hflocki/camper-heater/docs/lochraster.png

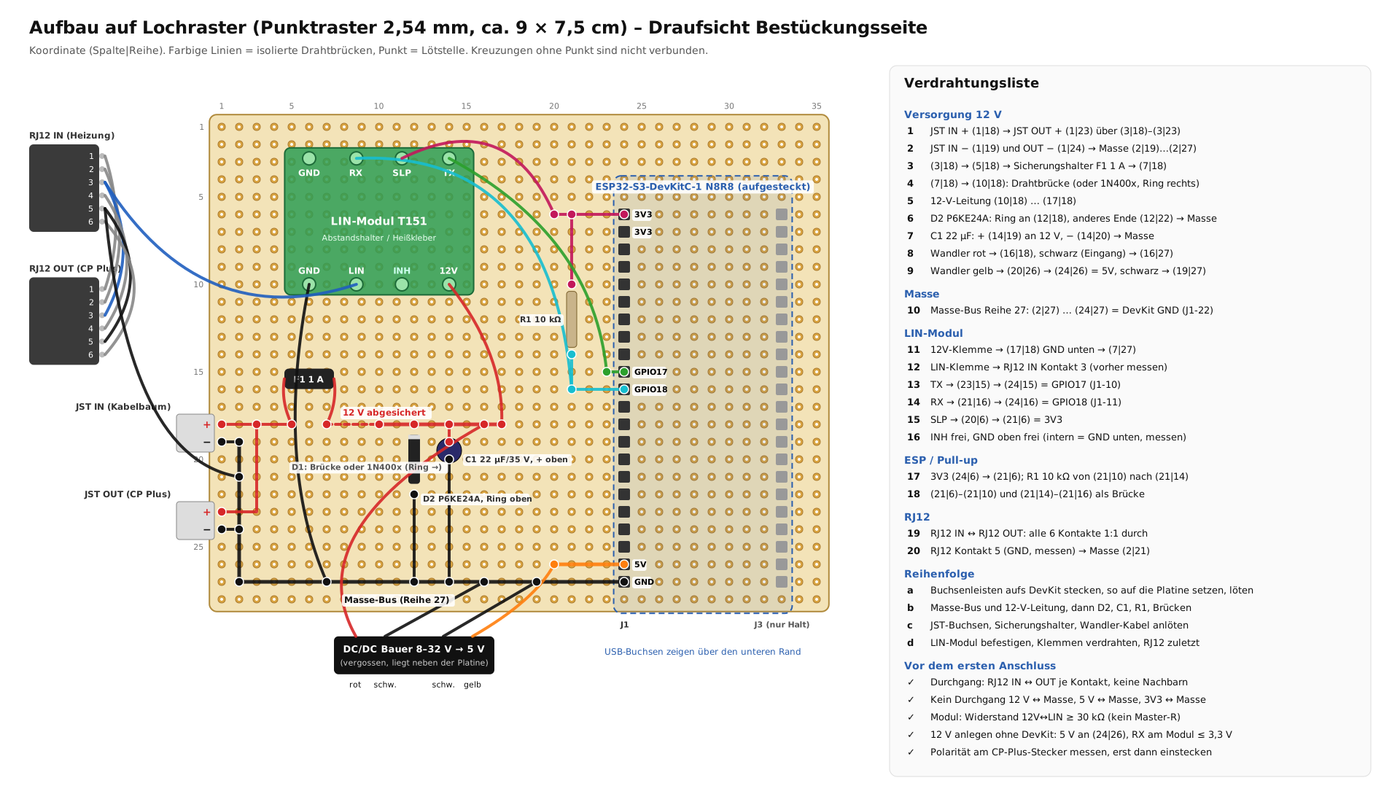
docs/lochraster.png
