hflocki/camper-heater/docs/lochraster_c3.png

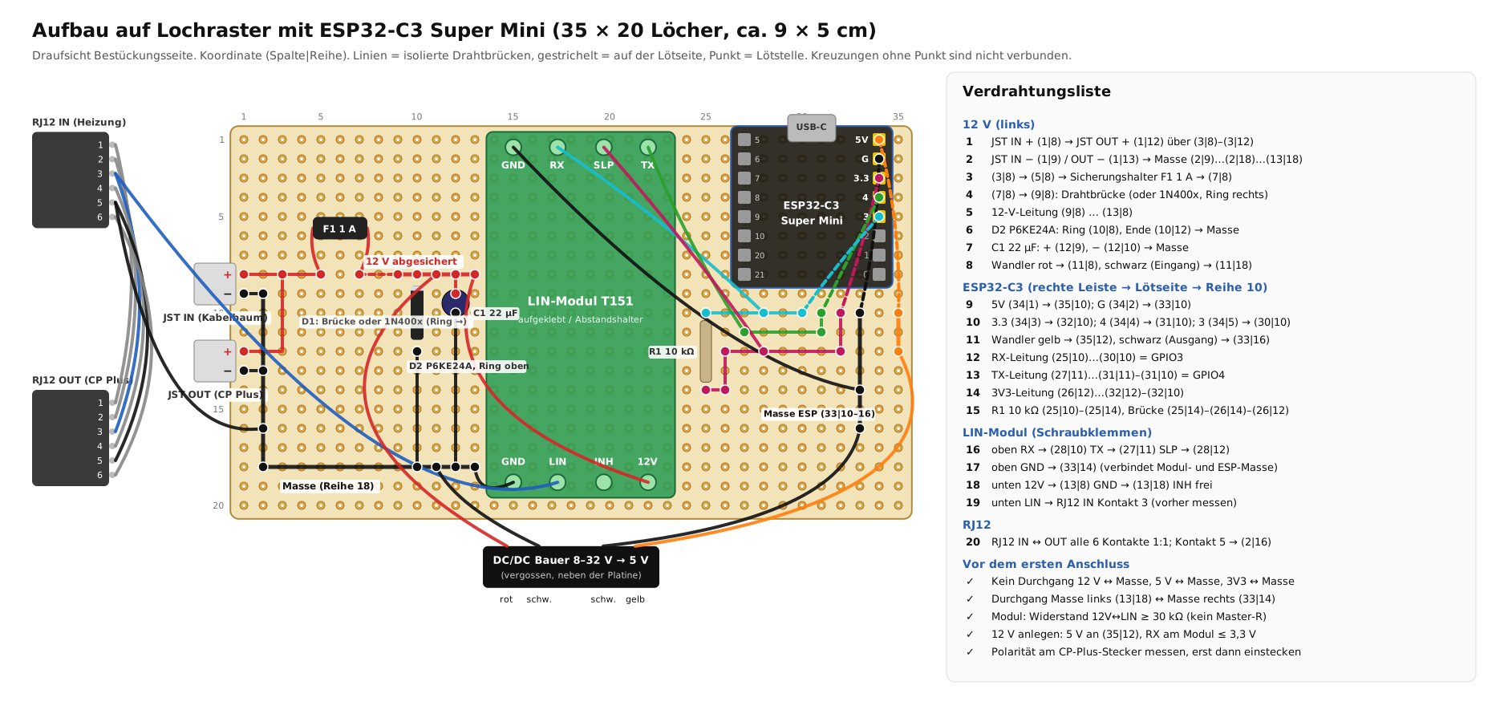
docs/lochraster_c3.png
