hflocki/camper-heater/docs/schaltplan.png

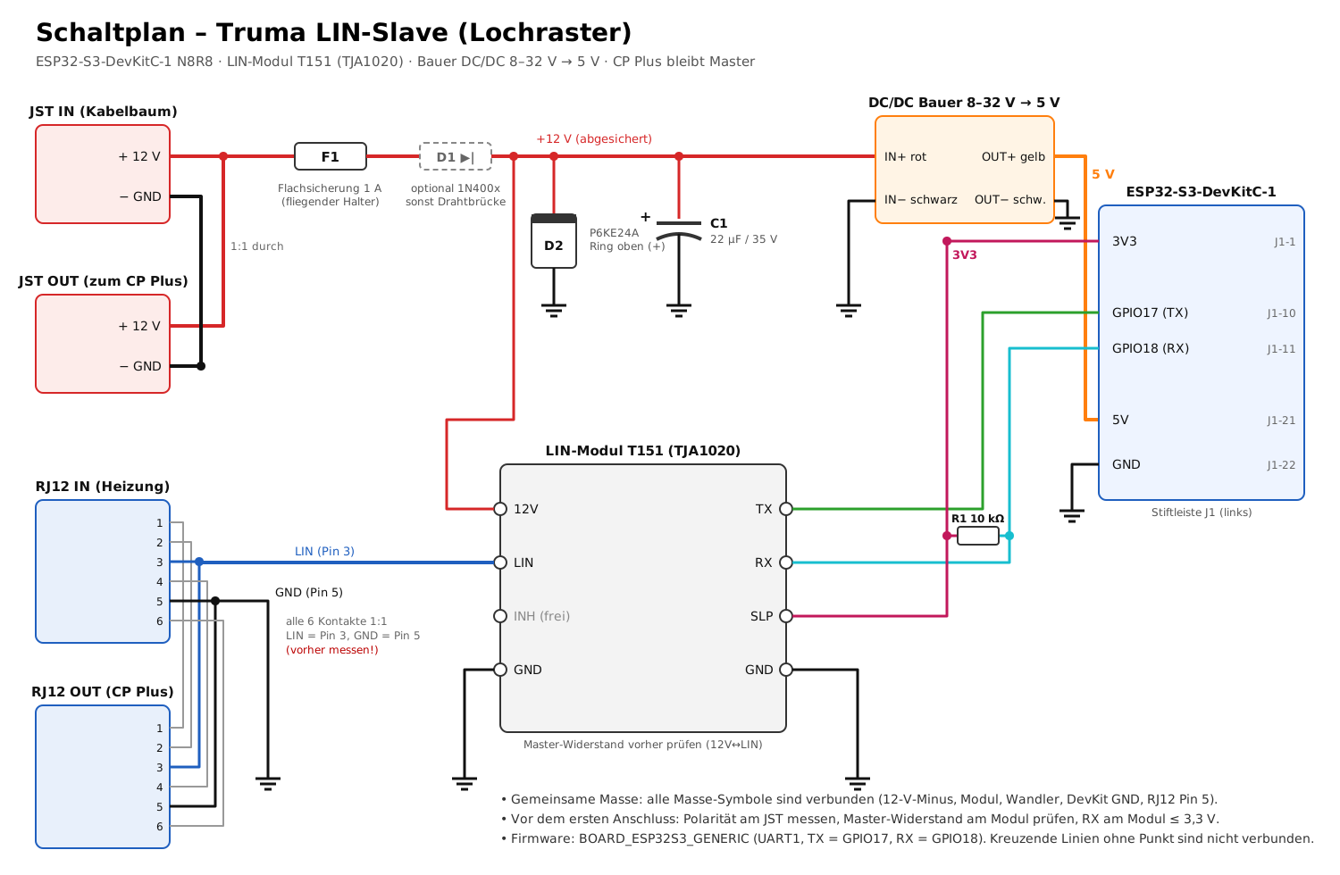
docs/schaltplan.png
