hflocki/camper-heater/docs/wiring_esp32s3_tja1020.png

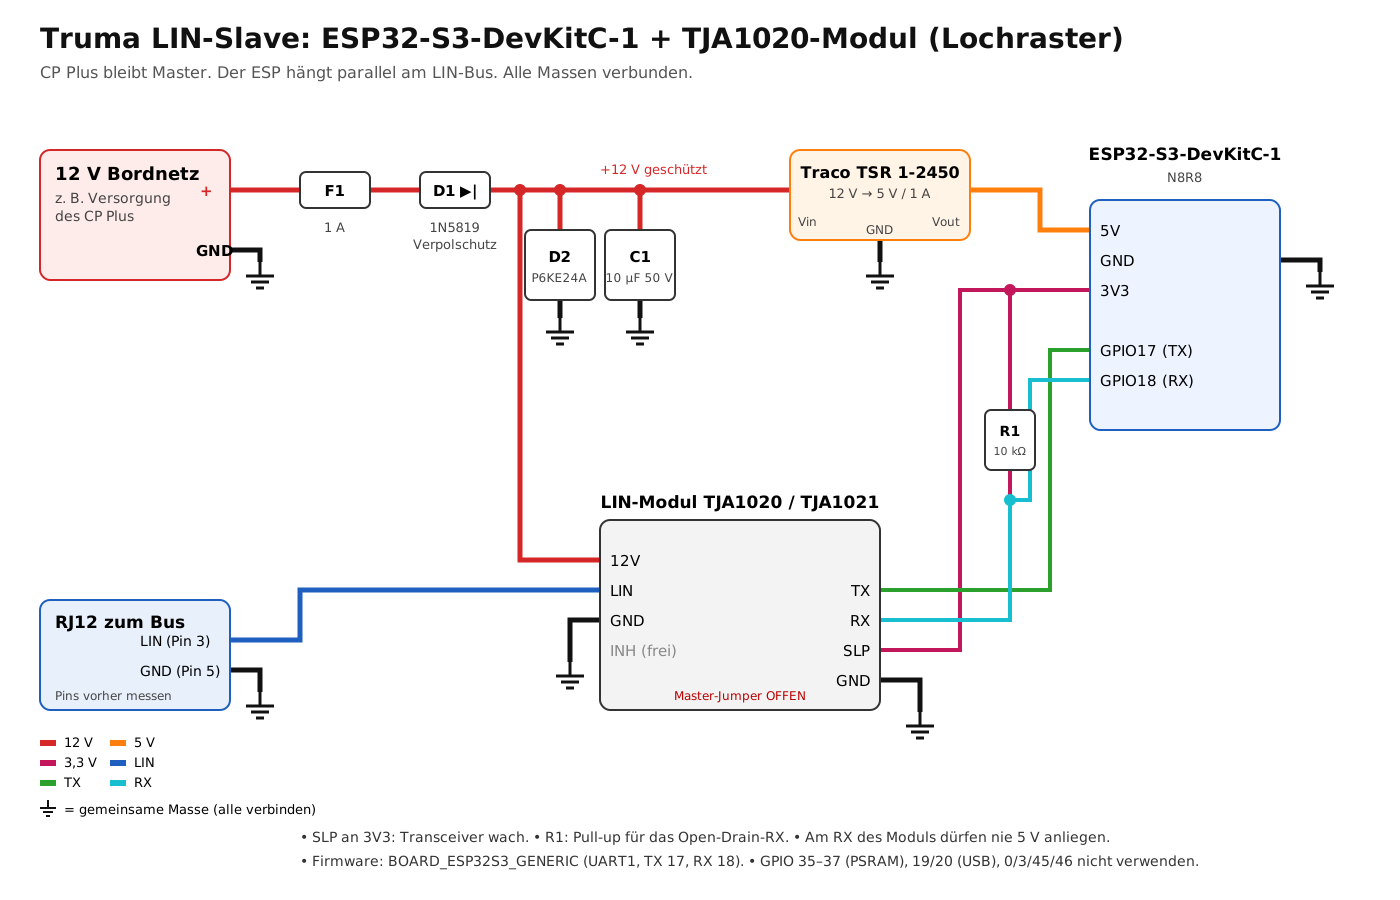
docs/wiring_esp32s3_tja1020.png
