hflocki/camper-heater/(commit log)

2026-10-14 Initial version: Truma iNet Box emulation over LIN with MQTT
    Arduino firmware for ESP32 boards with a LIN transceiver. The ESP acts as
    LIN slave (iNet Box), the CP Plus stays master. MQTT topics compatible with
    inetbox2mqtt, Home Assistant discovery, web UI with live log and OTA.
    Claude-Session: https://claude.ai/code/session_01V8JBHwqyDuTDRa74HcRfnB
2026-10-15 Add CP Plus timer setting (MQTT, Home Assistant, web UI)
    Timer response frame (0x3C) ported from havanti/esphome-truma
    (TrumaiNetBoxAppTimer, GPL-3.0). New MQTT commands set/timer and
    set/timer_active, HA text entity + switch, timer card in the web UI,
    host test for frame layout and checksum.
    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
2026-10-15 Tests: replay all WomoLIN captures, compare all app commands
    Adds the remaining 22 WomoLIN captures. run.sh now replays every
    capture and checks our heater update payload against the original
    iNet Box for all 14 Truma app commands (all identical).
    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
2026-10-15 Heater errors: flag every non-zero code, log changes
    heater_error was only ON when the high byte was set. E212 arrives as
    low byte 0xD4 / high 0x00 (havanti 1.0.42) and the WomoLIN capture
    shows code 255 right after CP Plus start, so any non-zero code is now
    reported. Error code changes are logged. The code stays numeric like
    in inetbox.py, inetbox2mqtt and ESPHome.
    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
2026-10-15 Observer mode: keep the LIN transceiver awake
    The CS pin was driven LOW in observer mode, which puts a TJA1020/1021
    to sleep, so the ESP could not hear the bus any more. Now it stays HIGH;
    observer mode only suppresses our answers.
    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
2026-10-16 Hardware: reference build ESP32-S3-DevKitC-1 + TJA1020 module
    Parts list, wiring diagram, Arduino IDE settings and a three-stage
    bring-up (USB only, 12 V on the bench, on the bus) for a perfboard
    build from ready-made modules.
    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
2026-10-16 Hardware: schematic and perfboard layout for the module build
    Schematic and a hole-by-hole perfboard plan (with wiring list and
    pre-power checks) for ESP32-S3-DevKitC-1, LIN module T151, potted
    DC/DC converter and JST/RJ12 pass-through. Generated by the scripts
    in docs/.
    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
2026-10-16 Add ESP32-C3 Super Mini board profile, schematic and perfboard plan
    - config.h: BOARD_ESP32C3_SUPERMINI (UART1, TX GPIO4, RX GPIO3, on-board
    LED GPIO8 active low, WiFi TX power 8.5 dBm). GPIO20/21 avoided because
    the ROM boot log on GPIO21 would end up on the LIN bus.
    - WIFI_TX_POWER_QDBM can now be overridden per profile.
    - Schematic and perfboard layout with wiring list for the C3 build.
    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
    [config.h]
2026-10-16 C3 Super Mini plan: power pins on the right in top view
    The Super Mini has 5V/G/3.3/4/3/2/1/0 on the right header when seen from
    the top with USB up. Layout mirrored accordingly, the five used pins are
    wired on the solder side to transfer points below the module.
    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
2026-10-16 Make ESP32-C3 Super Mini the default board profile
    Generic board name for the C3 build; smartavan profile stays available
    as an option.
    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
2026-10-17 Add community captures (heater ventilation, aircon AUTO), report fan action
    - tests: parse ESPHome truma_inetbox observer logs, replay with fixed NAD,
    8 community captures decode without checksum errors
    - Ventilation levels 1-10 set on the CP Plus are not reported in the heater
    status frame; only the operating status changes. hvac_action is now 'fan'
    when the heater runs with room and water off
    - Document aircon AUTO findings (status 0x35 mode 7, write frame 0x34)
    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
2026-10-17 Timer frame: 18 bytes as sent by the original iNet Box
    Community captures (Truma app sets / changes / clears the timer) show the
    original iNet Box sending frame 0x3C with length 0x12: the known 17-byte
    layout plus a trailing zero byte. Our timer frames are now byte-identical
    for all three commands; run.sh checks this against the capture.
    Also adds the timer (heater/aircon) and clock captures and documents the
    aircon timer frames 0x3E/0x3F and that the iNet Box never sets the clock.
    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
2026-10-19 Add LIN sniffer for bus exploration
    Logs every changed frame of all PIDs except the iNet Box traffic
    (0x18/0x3C/0x3D) as 'SNIFF PID xx: ...' warnings, so it shows up in the
    web and MQTT log. Switch via web UI (System) or MQTT set/sniffer, off
    after reboot. Meant to find the heater ventilation level, which is not
    part of the iNet Box frames (Combi D6 E uses PIDs 0x03-0x07, not 0x20).
    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
2026-10-21 Read the ventilation level from LIN frame 0x20
    Some heaters receive their fan/ventilation setting from the CP Plus in
    PID 0x20 (byte 5, high nibble, as in inetbox2mqtt / esphome VENT_MODE).
    A community capture confirms levels 1-10 with the ESPHome VENT_MODE
    sensor. The firmware now listens passively and publishes vent_level /
    vent_mode (HA sensor 'Ventilation level'); nothing is published on
    heaters without this frame. Also adds the ACC and vent sensor captures.
    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
2026-10-22 docs: clickable web UI mockup and screenshots
    docs/gen_mockup.py builds docs/mockup/truma-heater-mockup.html from the
    real web_ui.h with a simulated device API, so the UI can be tried in a
    browser without an ESP32. Screenshots of all three tabs in the README.
    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
2026-10-22 Shore power capture: aircon online state in the device list
    No frame carries a shore power flag. The 230 V Aventa aircon appears on the
    bus with shore power and the CP Plus re-sends the device list with its
    state online/offline. The firmware now logs the state of each device.
    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
2026-10-22 Rename project to camper-heater
    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
2026-10-23 Web UI and WiFi handling in the style of camper-tanklevel
    - Dark UI with icon tabs (Heizung, Timer, MQTT, WiFi, System) and status
    dots for CP Plus, WiFi and MQTT; each tab saves only its own fields
    - WiFi tab: connection status, drops, last drop reason, reset reason,
    TX power, access point name/password, 'access point always on'
    - WiFi state machine: AP only without WiFi or as fallback after 60 s;
    in fallback a 10 s station attempt every 30 s, never while a phone is
    connected to the AP; an always-on AP runs on the router channel
    - Settings: ap_ssid, ap_always, wifi_tx_power; checkboxes only change
    when the saved tab contains them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
    [gen_mockup.py]
2026-10-23 Unify camper devices: topics, alarms, web login, CI
